Cable89/oysm_nrf_keyboard/(threads)

Thread 2 (2020-12-11):

C41 collides with battery connector

Cable89, 2020-12-11:
C41 collides with J2 battery connector when plugging in or removing battery lead.
Move it up to the right.

Thread 3 (2020-12-11):

Switch footprints does not fit Kailh choc

Cable89, 2020-12-11:
Switch footprints does not fit Kailh choc low profile switches.
It should be possible to modify the footprint to fit choc as well as box switches. Maybe it will be tight around the MCU?

Thread 4 (2020-12-11):

Pull resistors for USB-C connector not to spec

Cable89, 2020-12-11:
Supposed to be different configuration of pull resistors to work with a USB-C connection on host side.
Current configuration is working for USB 2.0 host.

Thread 5 (2020-12-11):

Add push button for comissioning

Cable89, 2020-12-11:
Currently no button for initiating pairing.
Should have a button on the side next to power switch. Maybe move charging indication LED?

Thread 6 (2020-12-11):

U4 VCC is not connected to VDD_P3V3

Cable89, 2020-12-11:
Label on U4 supply was connected to VCC_P3V3, not VDD_P3V3. Thus no 3.3V on the supply pin of U4 (Level shifter for the LEDs)

Thread 7 (2023-12-06):

Replace PMIC with nPM1300

tovine, 2023-12-06:
Clearly not an unbiased opinion, but it would be a nice showcase and could replace both U2 and U3 while adding more status LED capabilities 😁
