Cable89/oysm_nrf_keyboard/(list of files, drawings)

Other design files:
Button.SchLib
Key.PcbLib
oysm_Keyboard.PrjPCB
oysm_Keyboard_Buttons.SchDoc
oysm_Keyboard_LEDs.SchDoc
oysm_Keyboard_MCU.SchDoc
oysm_Keyboard_Power_supply.SchDoc
oysm_Keyboard_Top.SchDoc
