Cable89/oysm_nrf_keyboard/(commit log)

2020-02-07 Moved switches to OVLib, sized pcb, fit nrf in between switches
    [oysm_Keyboard_Buttons.SchDoc, oysm_Keyboard_MCU.SchDoc]
2020-02-07 Added chip antenna
    [oysm_Keyboard_MCU.SchDoc]
2020-02-07 Added battery charging
    [oysm_Keyboard.PrjPCB, oysm_Keyboard_Buttons.SchDoc, oysm_Keyboard_MCU.SchDoc, oysm_Keyboard_Power_supply.SchDoc, oysm_Keyboard_Top.SchDoc]
2020-02-07 Cleaned up designators
    [oysm_Keyboard_Buttons.SchDoc, oysm_Keyboard_MCU.SchDoc, oysm_Keyboard_Power_supply.SchDoc]
2020-02-07 Connected the last nets
    [oysm_Keyboard_Buttons.SchDoc, oysm_Keyboard_MCU.SchDoc, oysm_Keyboard_Power_supply.SchDoc, oysm_Keyboard_Top.SchDoc]
2020-02-07 Saved files
    [oysm_Keyboard.PrjPCB]
2020-02-08 Added LEDs
    [oysm_Keyboard.PrjPCB, oysm_Keyboard_Buttons.SchDoc, oysm_Keyboard_LEDs.SchDoc, oysm_Keyboard_MCU.SchDoc, oysm_Keyboard_Power_supply.SchDoc, oysm_Keyboard_Top.SchDoc]
2020-02-09 Added USB-C connector
    [oysm_Keyboard_LEDs.SchDoc, oysm_Keyboard_MCU.SchDoc]
2020-02-09 routed the last buttons on new pinout
    [oysm_Keyboard_MCU.SchDoc]
2020-02-09 Optimized ground paths
2020-02-09 Added slots
2020-02-09 Shrunk one pad ring to get better ground connection
2020-02-21 Added solderbridge shortcuts on LED lines to skip cut off parts
    [oysm_Keyboard_LEDs.SchDoc]
2020-03-03 Generated production files
    [oysm_Keyboard.PrjPCB]
2020-03-03 Changed soldermask color
2020-10-10 Generated BOM
    [bom_documentation.xlsx]
2020-10-10 Removed some columns and regenerated BOM
    [bom_documentation.xlsx]
